patrickwasp/vindriktning-iot/pcb/vindriktrning-esp32-s3/vindriktrning-esp32-s3.kicad_pcb

## KiCad design pcb/vindriktrning-esp32-s3/vindriktrning-esp32-s3.kicad_pcb (2025-04-07)

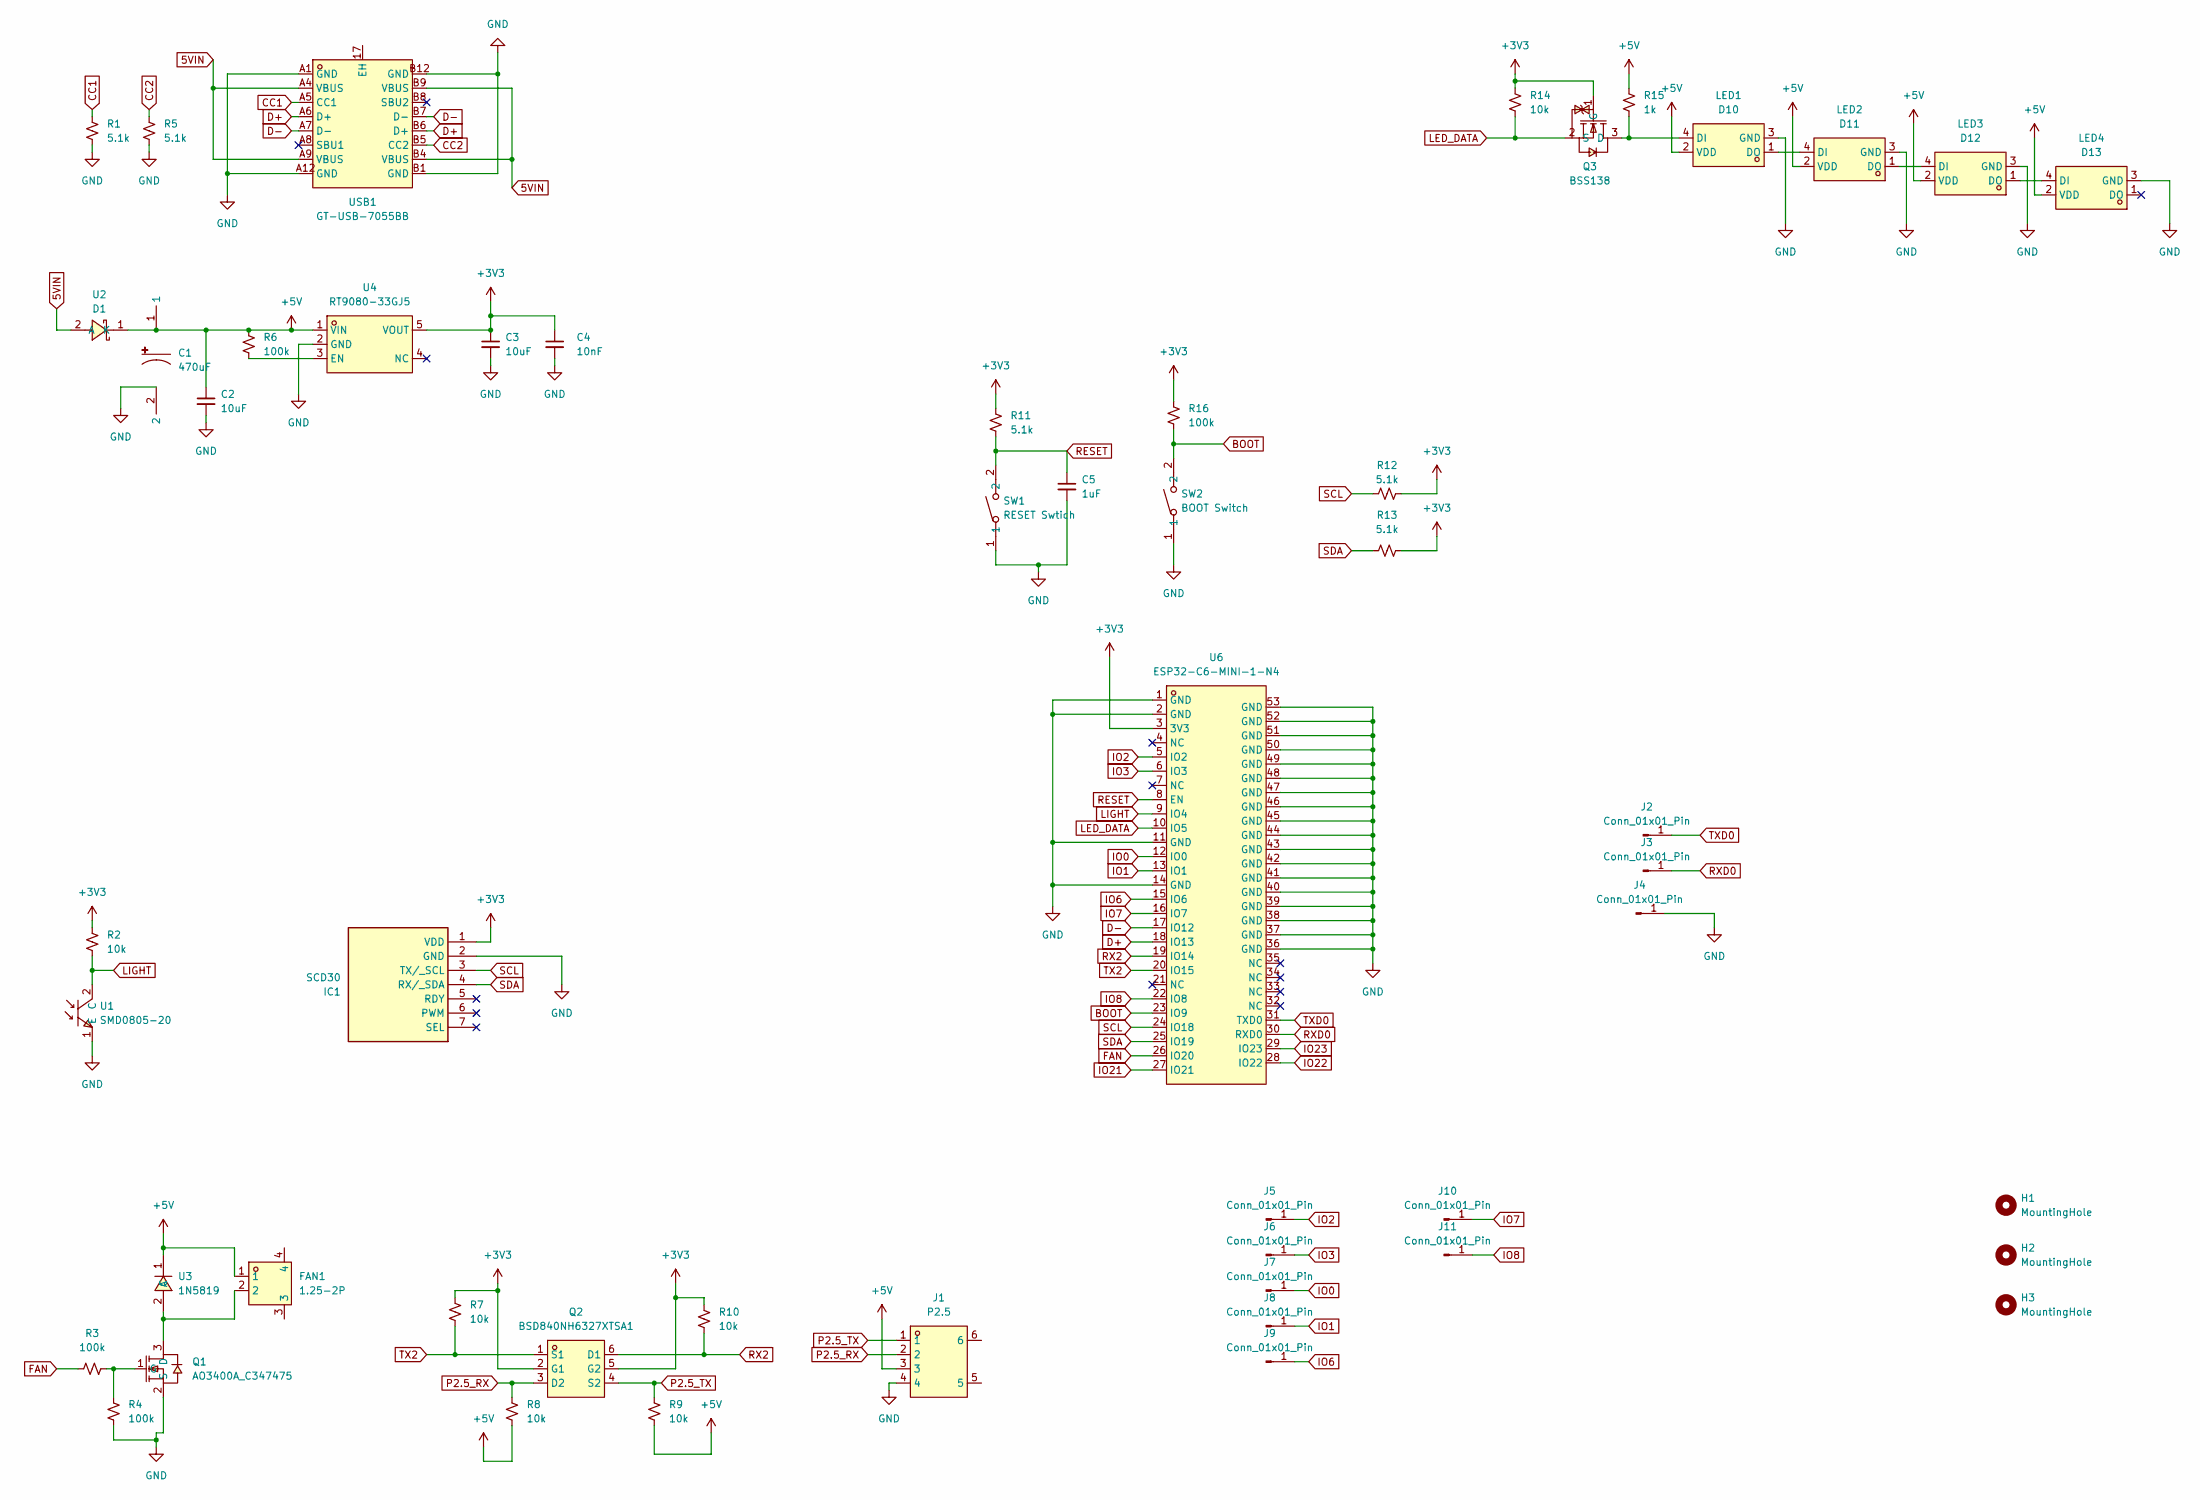
[picture p1: schematic vindriktrning-esp32-s3.kicad_sch]

Parts:
C1: 470uF; CAP-SMD_BD6.3-L6.6-W6.6-FD; LCSC Part C335982
C2, C3: 10uF; C_0805_2012Metric; LCSC C15850
C4: 10nF; C_0805_2012Metric; LCSC C1710
C5: 1uF; C_0805_2012Metric; LCSC C28323
FAN1: 1.25-2P; CONN-SMD_1.25-2P; LCSC Part C393945
H1, H2, H3: MountingHole; MountingHole_2.2mm_M2
IC1: SCD30; Mouser Part Number 403-SCD30
J1: P2.5; CONN-SMD_ZH1.5-4AB; LCSC Part C145997
J2, J3, J4, J5, J6, J7, J8, J9, J10, J11: Conn_01x01_Pin; TestPoint_Pad_D1.0mm
LED1: D10; LED-SMD_4P-L1.6-W1.5_XL-1615RGBC-WS2812B; LCSC Part C5349954
LED2: D11; LED-SMD_4P-L1.6-W1.5_XL-1615RGBC-WS2812B; LCSC Part C5349954
LED3: D12; LED-SMD_4P-L1.6-W1.5_XL-1615RGBC-WS2812B; LCSC Part C5349954
LED4: D13; LED-SMD_4P-L1.6-W1.5_XL-1615RGBC-WS2812B; LCSC Part C5349954
Q1: AO3400A_C347475; SOT-23-3_L2.9-W1.3-P1.90-LS2.4-BR; LCSC Part C347475
Q2: BSD840NH6327XTSA1; SC-70-6_L2.2-W1.3-P0.65-LS2.1-BR; LCSC Part C151516
Q3: BSS138; SOT-23-3_L2.9-W1.3-P1.90-LS2.4-BR; LCSC Part C5224263
R1, R5, R11, R12, R13: 5.1k; R_0603_1608Metric; LCSC C23186
R2, R7, R8, R9, R10, R14: 10k; R_0603_1608Metric; LCSC C25804
R3, R4, R6, R16: 100k; R_0603_1608Metric; LCSC C25803
R15: 1k; R_0603_1608Metric; LCSC C21190
SW1: RESET Swtich; SW-SMD_L3.9-W3.0-P4.45; LCSC Part C720477
SW2: BOOT Switch; SW-SMD_L3.9-W3.0-P4.45; LCSC Part C720477
U1: SMD0805-20; OPTO-SMD_SMD0805-20; LCSC Part C250858
U2: D1; SOD-123_L2.7-W1.6-LS3.7-RD-1; LCSC Part C917121
U3: 1N5819; SOD-323_L1.7-W1.3-LS2.6-RD-1; LCSC Part C2891705
U4: RT9080-33GJ5; TSOT-23-5_L2.9-W1.6-P0.95-LS2.8-BL; LCSC Part C841192
U6: ESP32-C6-MINI-1-N4; WIFIM-SMD_61P-L16.6-W13.2-P0.80-ESP32-C6-MINI-1-N4; LCSC Part C5736265
USB1: GT-USB-7055BB; USB-C-TH_GT-USB-7055BB; LCSC Part C7450621

Connections:
5VIN: U2.2 (A), USB1.A4 (VBUS), USB1.A9 (VBUS), USB1.B4 (VBUS), USB1.B9 (VBUS)
+3V3: C3.1, C4.1, IC1.1 (VDD), Q2.2 (G1), Q2.5 (G2), Q3.1 (G), R2.1, R7.1, R10.1, R11.1, R12.2, R13.2, R14.1, R16.1, U4.5 (VOUT), U6.3 (3V3)
+5V: C1.1, C2.1, FAN1.1, J1.3, LED1.2 (VDD), LED2.2 (VDD), LED3.2 (VDD), LED4.2 (VDD), R6.1, R8.2, R9.2, R15.1, U2.1 (K), U3.1 (C), U4.1 (VIN)
BOOT: R16.2, SW2.2, U6.23 (IO9)
CC1: R1.1, USB1.A5 (CC1)
CC2: R5.1, USB1.B5 (CC2)
D+: U6.18 (IO13), USB1.A6 (D+), USB1.B6 (D+)
D-: U6.17 (IO12), USB1.A7 (D-), USB1.B7 (D-)
FAN: R3.1, U6.26 (IO20)
GND: C1.2, C2.2, C3.2, C4.2, C5.2, IC1.2 (GND), J1.4, J4.1, LED1.3 (GND), LED2.3 (GND), LED3.3 (GND), LED4.3 (GND), Q1.2 (S), R1.2, R4.2, R5.2, SW1.1, SW2.1, U1.1 (E), U4.2 (GND), U6.1 (GND), U6.2 (GND), U6.11 (GND), U6.14 (GND), U6.36 (GND), U6.37 (GND), U6.38 (GND), U6.39 (GND), U6.40 (GND), U6.41 (GND), U6.42 (GND), U6.43 (GND), U6.44 (GND), U6.45 (GND), U6.46 (GND), U6.47 (GND), U6.48 (GND), U6.49 (GND), U6.50 (GND), U6.51 (GND), U6.52 (GND), U6.53 (GND), USB1.A1 (GND), USB1.A12 (GND), USB1.B1 (GND), USB1.B12 (GND)
IO0: J7.1, U6.12 (IO0)
IO1: J8.1, U6.13 (IO1)
IO2: J5.1, U6.5 (IO2)
IO3: J6.1, U6.6 (IO3)
IO6: J9.1, U6.15 (IO6)
IO7: J10.1, U6.16 (IO7)
IO8: J11.1, U6.22 (IO8)
IO21: U6.27 (IO21)
IO22: U6.28 (IO22)
IO23: U6.29 (IO23)
LED_DATA: Q3.2 (S), R14.2, U6.10 (IO5)
LIGHT: R2.2, U1.2 (C), U6.9 (IO4)
unnamed: LED1.4 (DI), Q3.3 (D), R15.2
unnamed: LED1.1 (DO), LED2.4 (DI)
unnamed: LED2.1 (DO), LED3.4 (DI)
unnamed: LED3.1 (DO), LED4.4 (DI)
unnamed: FAN1.2, Q1.3 (D), U3.2 (A)
unnamed: Q1.1 (G), R3.2, R4.1
unnamed: R6.2, U4.3 (EN)
P2.5_RX: J1.2, Q2.3 (D2), R8.1
P2.5_TX: J1.1, Q2.4 (S2), R9.1
RESET: C5.1, R11.2, SW1.2, U6.8 (EN)
RX2: Q2.6 (D1), R10.2, U6.19 (IO14)
RXD0: J3.1, U6.30 (RXD0)
SCL: IC1.3 (TX/_SCL), R12.1, U6.24 (IO18)
SDA: IC1.4 (RX/_SDA), R13.1, U6.25 (IO19)
TX2: Q2.1 (S1), R7.2, U6.20 (IO15)
TXD0: J2.1, U6.31 (TXD0)

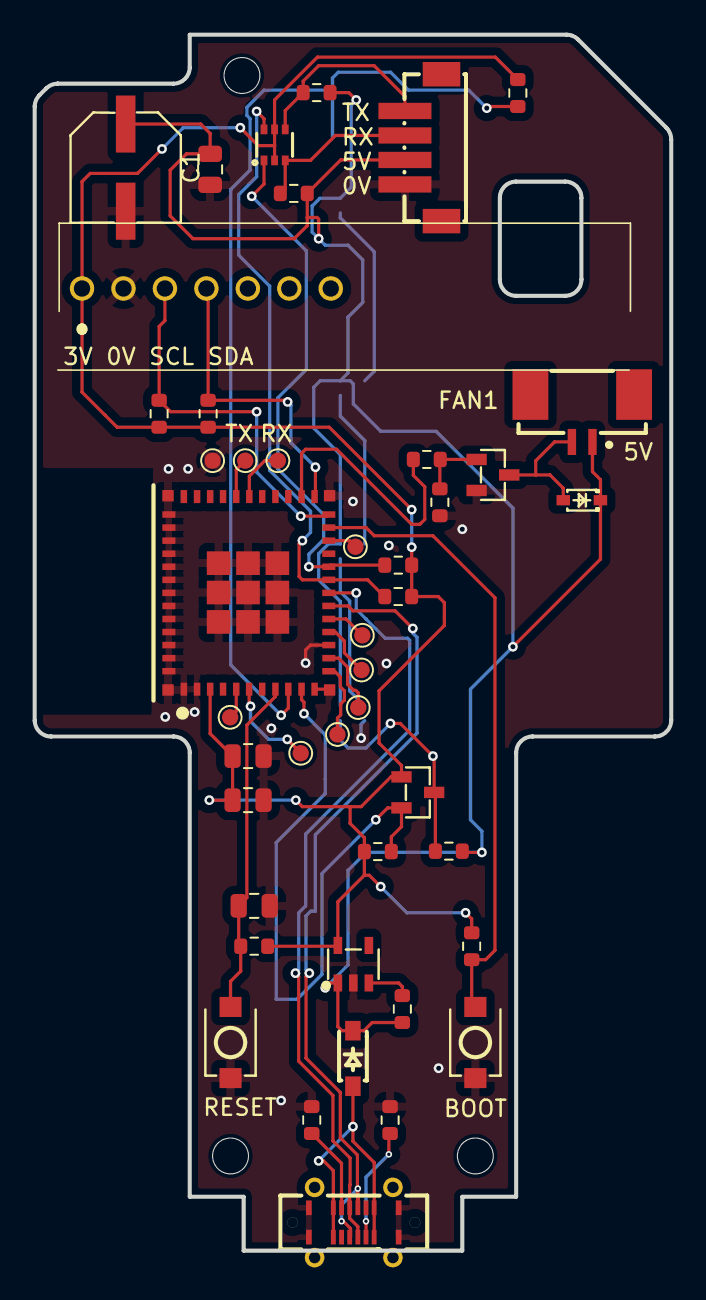
[picture p2: board vindriktrning-esp32-s3.kicad_pcb from above]

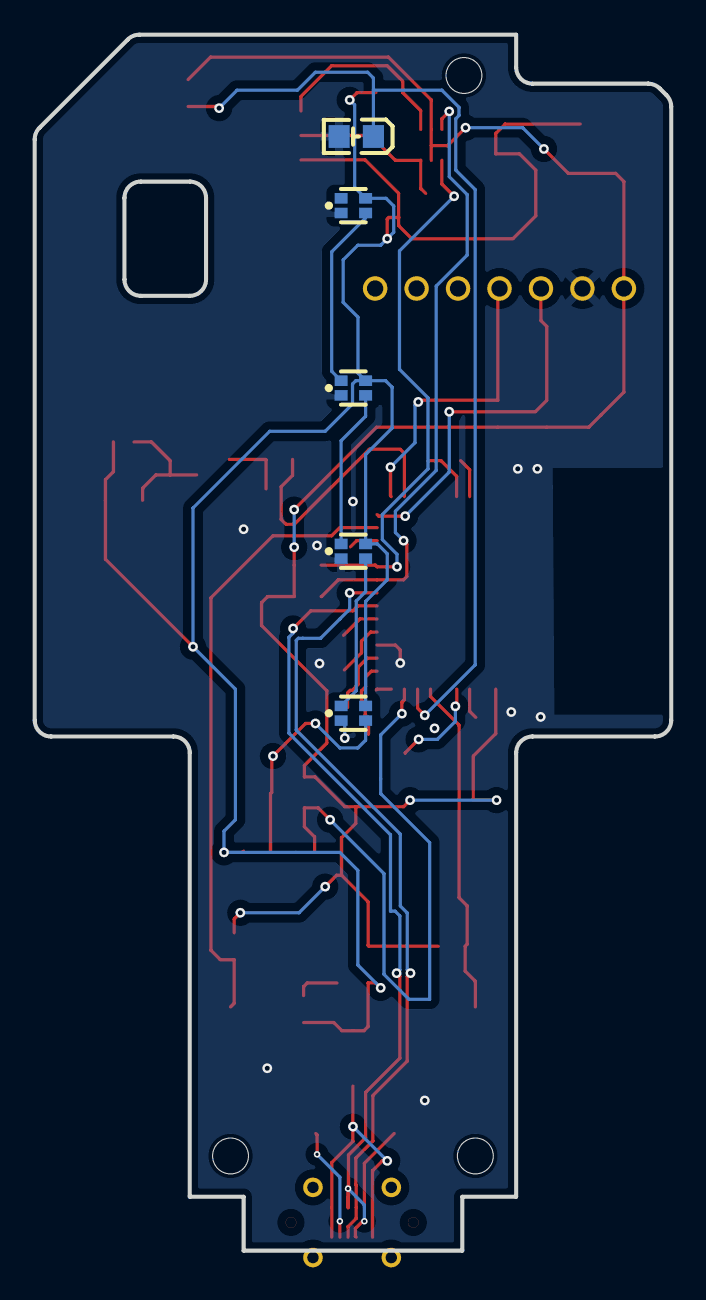
[picture p3: board vindriktrning-esp32-s3.kicad_pcb from below]

Board: 4 copper layers, 39.0 x 74.5 mm, 52 parts (5 on the bottom side), 35 nets.
